boylem16/BioCube/README.md

# BioCube
Self contained environment designed to grow plants under different desired conditions
